KING7EVEN-LABS/PCB-DESIGN/ALTIUM DESIGN/README.md

# 🛠️ Altium Designer Hardware Projects

Welcome to the central hardware repository for custom Altium Designer PCB projects. This workspace contains fully engineered, multi-layer PCB layouts, custom library components, and manufacturing output files.

---

## 📁 Repository Directory & Projects

| Project Directory | Architecture / MCU | Layers | Description | Status |
| :--- | :--- | :---: | :--- | :---: |
| 🚀 [**ESP32-S3-DevKitM-1 Custom 4-Layer Hardware Baseboard**](./ESP32-S3-DevKitM-1%20Custom%204-Layer%20Hardware%20Baseboard/) | ESP32-S3 (Wi-Fi / BLE) | 4-Layer | High-speed IoT baseboard with native USB-C, custom footprints, and RF clearance | Completed |
| ⚡ [**ATMega 2560 Pro Square Form-Factor Controller Board**](./ATMega%202560%20Pro%20Square%20Form-Factor%20Controller%20Board/) | ATmega2560-16AU (AVR) | 4-Layer | Compact square form-factor MCU layout with optimized pin breakout & PDN | Completed |

---

## ⚙️ Standard Project Architecture

Every sub-directory in this repository adheres to a strict manufacturing-ready structure:

* `Docs/` — Component datasheets & pinout reference sheets.
* `Images/` — High-resolution renders, layer breakdowns, and schematics.
* `Libs/` — Custom integrated library packages, schematic libraries, footprint libraries and Component 3D STEP models. ( `LibPkg`, `.SchLib`, `.PcbLib`, `STEP`).
* `PDFs/` — Schematic & PCB Layout PDF exports.
* `Project Outputs/` — Gerber files (RS-274X), NC Drill, BOM, and Pick & Place (CPL) files.

---

## 👤 Author & Maintainer

<p align="center">
  <b>Designed & Engineered by Kousik P</b><br>
  <i>Hardware / PCB Design Engineer</i>
</p>

<p align="center">
  
  
  
</p>
