KING7EVEN-LABS/PCB-DESIGN/ALTIUM DESIGN/ESP32-S3-DevKitM-1 Custom 4-Layer Hardware Baseboard/Docs/ESP32 pinout sheet.xlsx

1 | GND_01
2 | GND_02
3 | 3V3
4 | GPIO0/RTC_GPIO0
5 | GPIO1/RTC_GPIO1/TOUCH1/ADC1_CH0
6 | GPIO2/RTC_GPIO2/TOUCH2/ADC1_CH1
7 | GPIO3/RTC_GPIO3/TOUCH3/ADC1_CH2
8 | GPIO4/RTC_GPIO4/TOUCH4/ADC1_CH3
9 | GPIO5/RTC_GPIO5/TOUCH5/ADC1_CH4
10 | GPIO6/RTC_GPIO6/TOUCH6/ADC1_CH5
11 | GPIO7/RTC_GPIO7/TOUCH7/ADC1_CH6
12 | GPIO8/RTC_GPIO8/TOUCH8/ADC1_CH7/SUBSPICS1
13 | GPIO9/RTC_GPIO9/TOUCH9/ADC1_CH8/FSPIHD/SUBSPIHD
14 | GPIO10/RTC_GPIO10/TOUCH10/ADC1_CH9/FSPICS0/FSPIIO4/SUBSPICS0
15 | GPIO11/RTC_GPIO11/TOUCH11/ADC2_CH0/FSPID/FSPIIO5/SUBSPID
16 | GPIO12/RTC_GPIO12/TOUCH12/ADC2_CH1/FSPICLK/FSPIIO6/SUBSPICLK
17 | GPIO13/RTC_GPIO13/TOUCH13/ADC2_CH2/FSPIQ/FSPIIO7/SUBSPIQ
18 | GPIO14/RTC_GPIO14/TOUCH14/ADC2_CH3/FSPIWP/FSPIDQS/SUBSPIWP
19 | GPIO15/RTC_GPIO15/U0RTS/ADC2_CH4/XTAL_32K_P
20 | GPIO16/RTC_GPIO16/U0CTS/ADC2_CH5/XTAL_32K_N
21 | GPIO17/RTC_GPIO17/U1TXD/ADC2_CH6
22 | GPIO18/RTC_GPIO18/U1RXD/ADC2_CH7/CLK_OUT3
23 | USB_D-/RTC_GPIO19/GPIO19/U1RTS/ADC2_CH8/CLK_OUT2
24 | USB_D+/RTC_GPIO20/GPIO20/U1CTS/ADC2_CH9/CLK_OUT1
25 | GPIO21/RTC_GPIO21
26 | GPIO26/SPICS1
27 | GPIO47/SPICLK_P_DIFF/SUBSPICLK_P_DIFF
28 | GPIO33/SPIIO4/FSPIHD/SUBSPIHD
29 | GPIO34/SPIIO5/FSPICS0/SUBSPICS0
30 | GPIO48/SPICLK_N_DIFF/SUBSPICLK_N_DIFF
31 | GPIO35/SPIIO6/FSPID/SUBSPID
32 | GPIO36/SPIIO7/FSPICLK/SUBSPICLK
33 | GPIO37/SPIDQS/FSPIQ/SUBSPIQ
34 | GPIO38/FSPIWP/SUBSPIWP
35 | MTCK/GPIO39/CLK_OUT3/SUBSPICS1
36 | MTDO/GPIO40/CLK_OUT2
37 | MTDI/GPIO41/CLK_OUT1
38 | MTMS/GPIO42
39 | U0TXD/GPIO43/CLK_OUT1
40 | U0RXD/GPIO44/CLK_OUT2
41 | GPIO45
42 | GND
43 | GND
44 | GPIO46
45 | EN
46 | GND_46
47 | GND_47
48 | GND_48
49 | GND_49
50 | GND_50
51 | GND_51
52 | GND_52
53 | GND_53
54 | GND_54
55 | GND_55
56 | GND_56
57 | GND_57
58 | GND_58
59 | GND_59
60 | GND_60
61 | GND_61
62 | GND_62
63 | GND_63
64 | GND_64
65 | GND_65
66 | GND_66
67 | GND_67
68 | GND_68
69 | GND_69
70 | GND_70
71 | GND_71
72 | GND_72
73 | GND_73
