KING7EVEN-LABS/PCB-DESIGN/ALTIUM DESIGN/ATMega 2560 Pro Square Form-Factor Controller Board/Docs/ATmega_2560_schematic.png

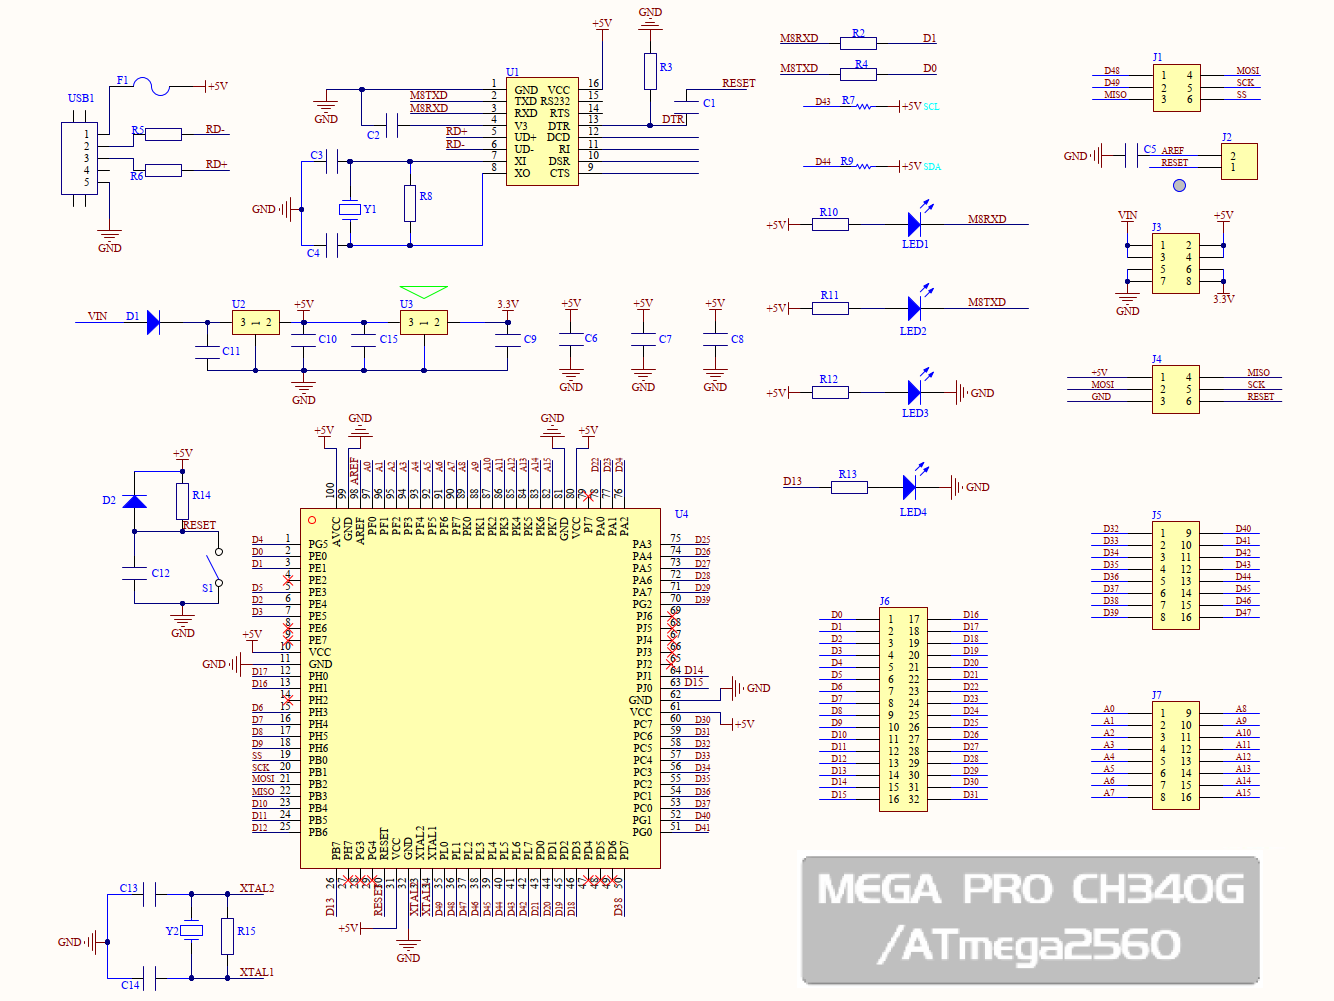
ALTIUM DESIGN/ATMega 2560 Pro Square Form-Factor Controller Board/Docs/ATmega_2560_schematic.png
