KING7EVEN-LABS/PCB-DESIGN/ALTIUM DESIGN/ATMega 2560 Pro Square Form-Factor Controller Board/Images/ATmega 2560 Footprint.png

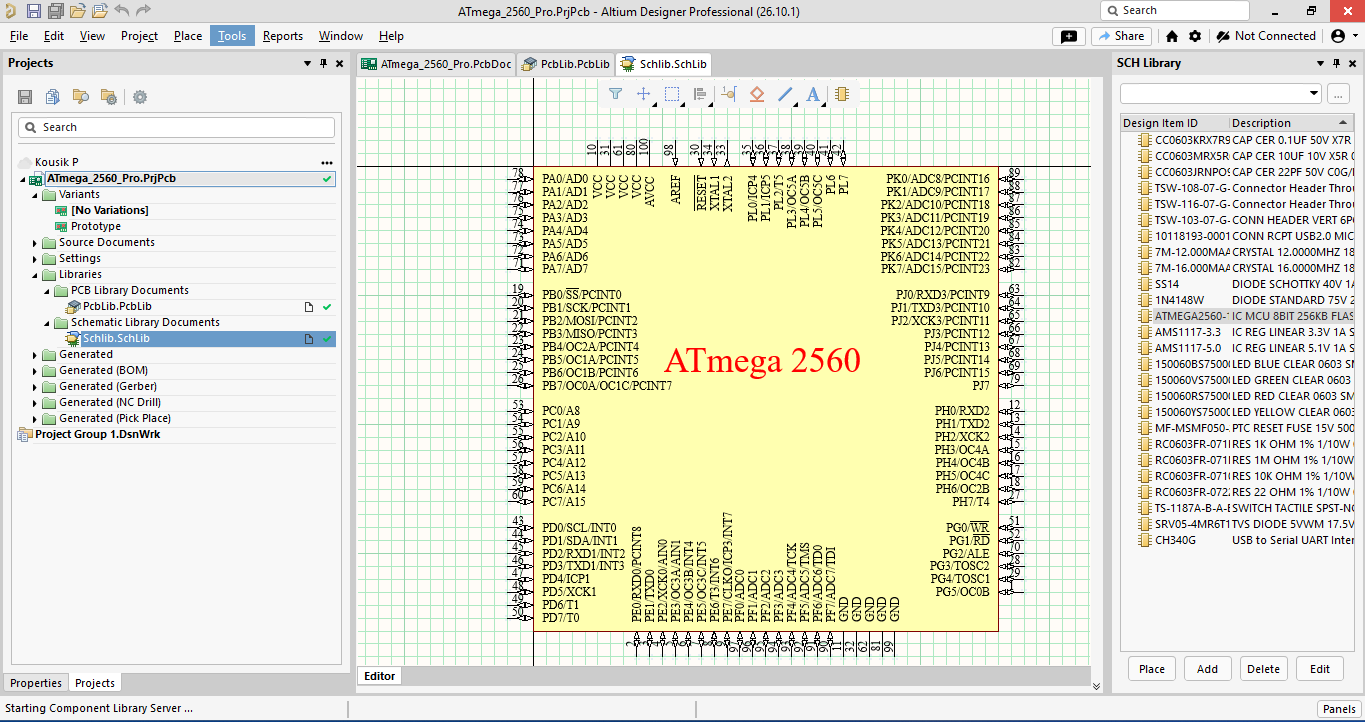
ALTIUM DESIGN/ATMega 2560 Pro Square Form-Factor Controller Board/Images/ATmega 2560 Footprint.png
