KING7EVEN-LABS/PCB-DESIGN/ALTIUM DESIGN/ESP32-S3-DevKitM-1 Custom 4-Layer Hardware Baseboard/Images/ESP32 S3 Footprint.png

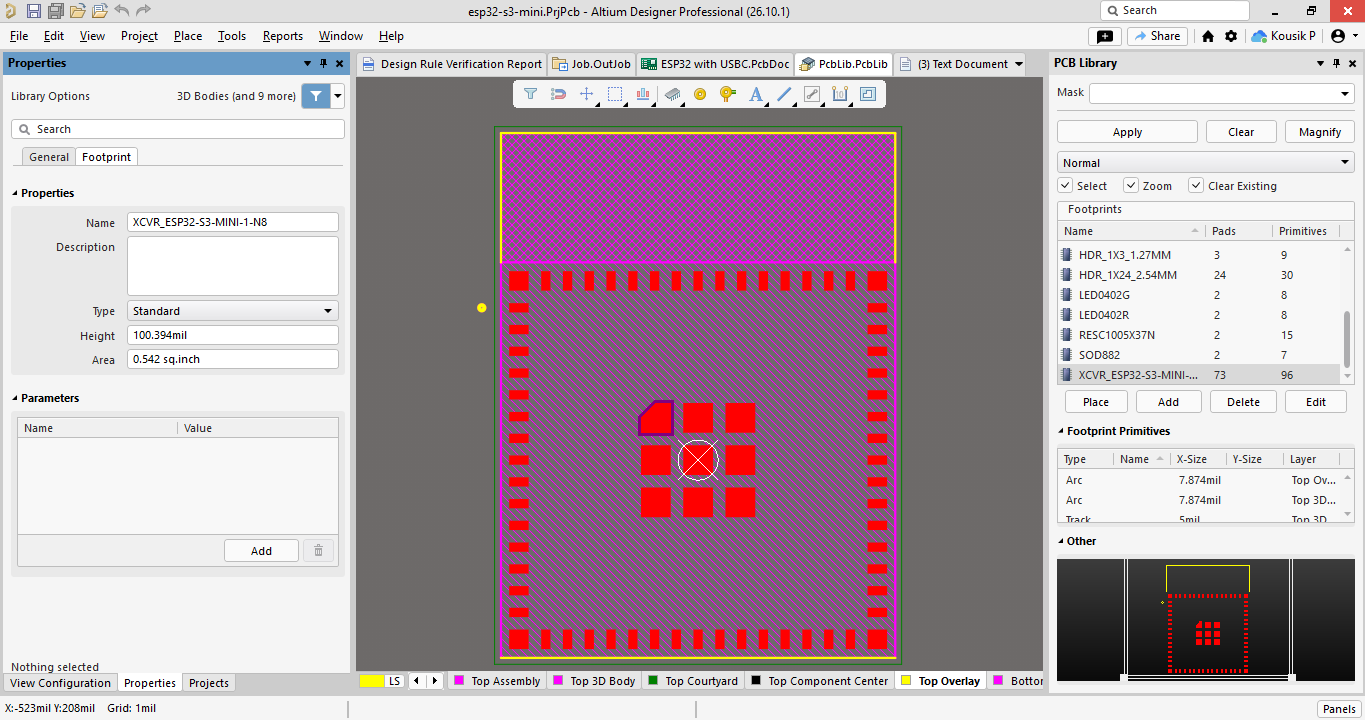
ALTIUM DESIGN/ESP32-S3-DevKitM-1 Custom 4-Layer Hardware Baseboard/Images/ESP32 S3 Footprint.png
