KING7EVEN-LABS/PCB-DESIGN/ALTIUM DESIGN/ATMega 2560 Pro Square Form-Factor Controller Board/Project Outputs for ATmega_2560_Pro/BOM/Bill of Materials-ATmega_2560_Pro(Prototype).xlsx

Name | Description | Designator | Footprint | LibRef | Quantity | Manufacturer | Supplier | Supplier Part Number
100nF | CAP CER 0.1UF 50V X7R 0603 | C1, C2, C7, C9, C10, C11, C12, C13, C14 | CAPC1608X90 - 100NF | CC0603KRX7R9BB104 | 9
22pF | CAP CER 22PF 50V C0G/NPO 0603 | C3, C4, C15, C16 | CAPC1608X90 - 22PF | CC0603JRNPO9BN220 | 4
10uF | CAP CER 10UF 10V X5R 0603 | C5, C6, C8 | CAPC1608X90 - 10UF | CC0603MRX5R6BB106 | 3 | Yageo Group | DigiKey | 311-1817-1-ND
1N4148W | DIODE STANDARD 75V 250MA SOD123 | D1 | SOD123_DIO | 1N4148W | 1
SS14 | DIODE SCHOTTKY 40V 1A DO214AC | D2 | DIOM4325X250N | SS14 | 1 | Taiwan Semiconductor | DigiKey | 1801-SS14CT-ND
500mA PTC | PTC RESET FUSE 15V 500MA 1812 | F1 | FUSM4632X85 | MF-MSMF050-2 | 1 | Bourns | DigiKey | MF-MSMF050-2CT-ND
Header Through Hole 32 position | Connector Header Through Hole 32 position 0.100" (2.54mm) | H1, H2 | SAMTEC_TSW-116-07-G-D | TSW-116-07-G-D | 2 | Samtec | DigiKey | 612-TSW-116-07-G-D-ND
Header Through Hole 16 position | Connector Header Through Hole 16 position 0.100" (2.54mm) | H3 | SAMTEC_TSW-108-07-G-D | TSW-108-07-G-D | 1 | Samtec | DigiKey | 612-TSW-108-07-G-D-ND
Header Through Hole 6 position | CONN HEADER VERT 6POS 2.54MM | H4 | SAMTEC_TSW-103-07-G-D | TSW-103-07-G-D | 1 | Samtec | DigiKey | 612-TSW-103-07-G-D-ND
Green Led | LED GREEN CLEAR 0603 SMD | LED1 | WL-SMCW_0603-G | 150060VS75000 | 1 | Wurth Elektronik | DigiKey | 732-4980-1-ND
Yellow Led | LED YELLOW CLEAR 0603 SMD | LED2 | WL-SMCW_0603-Y | 150060YS75000 | 1 | Wurth Elektronik | DigiKey | 732-4981-1-ND
Red Led | LED RED CLEAR 0603 SMD | LED3 | WL-SMCW_0603-R | 150060RS75000 | 1 | Wurth Elektronik | DigiKey | 732-4978-6-ND
Blue Led | LED BLUE CLEAR 0603 SMD | LED4 | WL-SMCW_0603-B | 150060BS75000 | 1 | Wurth Elektronik | DigiKey | 732-4966-6-ND
10k | RES 10K OHM 1% 1/10W 0603 | R1, R9, R10, R11 | RESC1607X60N - 10K | RC0603FR-0710KL | 4
22 | RES 22 OHM 1% 1/10W 0603 | R2, R3 | RESC1607X60N - 22 | RC0603FR-0722RL | 2 | Yageo Group | DigiKey | 311-22.0HRCT-ND
1M | RES 1M OHM 1% 1/10W 0603 | R4, R12 | RESC1607X60N - 1M | RC0603FR-071ML | 2
1k | RES 1K OHM 1% 1/10W 0603 | R5, R6, R7, R8, R13, R14 | RESC1607X60N - 1K | RC0603FR-071KL | 6
SW | SWITCH TACTILE SPST-NO 0.05A 12V SMD 3X4MM | S1 | SW_TS-1187A-B-A-B | TS-1187A-B-A-B | 1
CH340G | USB to Serial UART Interface Controller IC, SOP-16, 5V/3.3V, 12MHz External Crystal Required | U1 | SOP127P780X200-16N | CH340G | 1
AMS1117-5.0 | IC REG LINEAR 5.1V 1A SOT-223-3L | U2 | SOT229P700X180-4N-5.0 | AMS1117-5.0 | 1 | Revvo | DigiKey | 5272-AMS1117-5.0TR-ND
AMS1117-3.3 | IC REG LINEAR 3.3V 1A SOT-223-3L | U3 | SOT229P700X180-4N-3.3 | AMS1117-3.3 | 1 | UMW(Youtai Semiconductor Co., Ltd.) | DigiKey | 4518-AMS1117-3.3TR-ND
SRV05-4 | TVS DIODE 5VWM 17.5VC 6TSOP | U4 | TSOP6_3P1X1P7_ONS | SRV05-4MR6T1G | 1 | onsemi | DigiKey | 488-SRV05-4MR6T1GDKR-ND
ATMEGA2560-16AU | IC MCU 8BIT 256KB FLASH 100TQFP | U5 | QFP50P1600X1600X120-100N | ATMEGA2560-16AU | 1 | Microchip | DigiKey | ATMEGA2560-16AU-ND
Micro-USB-B | CONN RCPT USB2.0 MICRO B SMD R/A | USB1 | AMPHENOL_10118193-0001LF | 10118193-0001LF | 1 | Amphenol Communications Solutions | DigiKey | 609-4616-1-ND
12MHz | CRYSTAL 12.0000MHZ 18PF SMD | X1 | OSCCC250X320X70-4N | 7M-12.000MAAJ-T | 1
16MHZ | CRYSTAL 16.0000MHZ 18PF SMD | X2 | XTAL_7M-16.000MAAJ-T | 7M-16.000MAAJ-T | 1
