KING7EVEN-LABS/PCB-DESIGN/ALTIUM DESIGN/ESP32-S3-DevKitM-1 Custom 4-Layer Hardware Baseboard/Project Outputs for esp32-s3-mini/BOM/Bill of Materials-esp32-s3-mini(Prototype).xlsx

Name | Description | Designator | Footprint | LibRef | Quantity | LCSC Part Number | Manufacturer | Manufacturer Part Number | Supplier | Supplier Part Number
4u7,16v | CAP CER 4.7UF 16V X5R 0402 | C1, C11 | CAPC1005X65N | CL05A475MO5NUNC | 2 | C318563 | Samsung Electro-Mechanics | CL05A475MO5NUNC | DigiKey | 1276-6836-6-ND
100nF 50V | CAP CER 0.1UF 50V X7R 0402 | C2, C3, C4, C5, C6, C8, C9, C10, C15 | CAPC1005X65N | CL05B104KB54PNC | 9 | C307331 | Samsung Electro-Mechanics | CL05B104KB54PNC | DigiKey | 1276-CL05B104KB54PNCDKR-ND
10uF 10V | CAP CER 10UF 10V X5R 0402 | C12, C13, C14 | CAPC1005X65N | CL05A106MP8NUB8 | 3 | C307415 | Samsung Electro-Mechanics | CL05A106MP8NUB8 | DigiKey | 1276-6830-6-ND
1uF 35V | CAP CER 1UF 35V X5R 0402 | C16 | CAPC1005X65N | CL05A105KL5NRNC | 1 | C307413 | Samsung Electro-Mechanics | CL05A105KL5NRNC | DigiKey | 1276-6796-6-ND
AQ3045-01ETG | TVS DIODE 5.3VWM 12VC SOD882 | D1, D2, D3, D5, D6, D7 | SOD882 | AQ3045-01ETG | 6 | C3710326 | Littelfuse | AQ3045-01ETG | DigiKey | F9321CT-ND
GREEN | LED YLW-GRN 0402 SMD | D4 | LED0402G | VLMG1500-GS08 | 1 | C511404 | Vishay | VLMG1500-GS08 | DigiKey | VLMG1500-GS08DKR-ND
RED | LED RED 0402 SMD | D8 | LED0402R | VLMS1500-GS08 | 1 | C511370 | Vishay | VLMS1500-GS08 | DigiKey | VLMS1500-GS08CT-ND
22-28-4245 | CONN HEADER VERT 24POS 2.54MM | J1, J2 | HDR_1X24_2.54MM | 22-28-4245 | 2 | C7145888 | Molex | 22-28-4245 | DigiKey | 900-0022284245-ND
217179-0001 | CONN RCP USB2.0 TYP C 24P SMD RA | J3, J4 | FP-2171790001-MFG | 217179-0001 | 2 | C3197684 | Molex | 217179-0001 | DigiKey | 900-2171790001CT-ND
FTS-103-01-F-S | CONN HEADER VERT 3POS 1.27MM | J5 | HDR_1X3_1.27MM | FTS-103-01-F-S | 1 | C3333578 | Samtec | FTS-103-01-F-S | DigiKey | 612-FTS-103-01-F-S-ND
FTS-102-01-F-S | CONN HEADER VERT 2POS 1.27MM | J6 | HDR_1X2_1.27MM | FTS-102-01-F-S | 1 | C6045317 | Samtec | FTS-102-01-F-S | DigiKey | SAM15176-ND
M50-1920005 | CONN SHUNT 1.27MM RED | LINK1, LINK2 |  | M50-1920005 | 2 | C6985646 | Harwin | M50-1920005 | DigiKey | 952-1727-ND
SS8050-G | TRANS NPN 25V 1.5A SOT-23-3 | Q1, Q2 | FP-SS8050-G-IPC_B | SS8050-G | 2 | C164886 | Comchip | SS8050-G | DigiKey | 641-1790-1-ND
0R | RES 0 OHM JUMPER 1/16W 0402 | R1, R6, R21, R22, R23, R24 | RESC1005X37N | RC0402JR-070RL | 6 | C60485 | Yageo Group | RC0402JR-070RL | DigiKey | 311-0.0JRDKR-ND
27R | RES 27 OHM 1% 1/16W 0402 | R4, R5, R19, R20 | RESC1005X37N | RC0402FR-0727RL | 4 | C138021 | Yageo Group | RC0402FR-0727RL | DigiKey | YAG3086DKR-ND
4k7 | RES 4.7K OHM 1% 1/16W 0402 | R8 | RESC1005X37N | RC0402FR-074K7L | 1 | C105871 | Yageo Group | RC0402FR-074K7L | DigiKey | 311-4.7KLRCT-ND
5k1 | RES SMD 5.1K OHM 1% 1/16W 0402 | R9, R10, R13, R14 | RESC1005X37N | AC0402FR-075K1L | 4 | C144745 | Yageo Group | AC0402FR-075K1L | DigiKey | YAG3503CT-ND
10k | RES SMD 10K OHM 1% 1/16W 0402 | R11, R16, R17, R18 | RESC1005X37N | AC0402FR-0710KL | 4 | C144807 | Yageo Group | AC0402FR-0710KL | DigiKey | YAG3436DKR-ND
1k | RES 1K OHM 1% 1/16W 0402 | R12, R15 | RESC1005X37N | RC0402FR-071KL | 2 | C106235 | Yageo Group | RC0402FR-071KL | DigiKey | 311-1.00KLRDKR-ND
PTS645SH50SMTR92LFS | SWITCH TACTILE SPST-NO 0.05A 12V | SW1, SW2 | FP-PTS645SH50SMTR92LFS-MFG | PTS645SH50SMTR92LFS | 2 | C221869 | C&K Components | PTS645SH50SMTR92LFS | DigiKey | CKN9085CT-ND
ESP32-S3-MINI-1-N8 | 20.5dBm ESP32-S3FN8 Chip 2.4GHz SMD WiFi Modules ROHS | U1 | XCVR_ESP32-S3-MINI-1-N8 | ESP32-S3-MINI-1-N8 | 1 | C2913206 | Espressif Systems | ESP32-S3-MINI-1-N8 | DigiKey | 5407-ESP32-S3-MINI-1-N8DKR-ND
FT231XQ-R | IC USB SERIAL FULL UART 20QFN | U2 | FP-QFN-20-IPC_B | FT231XQ-R | 1 | C132159 | FTDI | FT231XQ-R | DigiKey | 768-1128-6-ND
TL1963A-33DCYR | IC REG LIN 3.3V 1.5A SOT-223-4 | U3 | DCY0004A_N | TL1963A-33DCYR | 1 | C181262 | Texas Instruments | TL1963A-33DCYR | DigiKey | 296-24897-1-ND
