KING7EVEN-LABS/PCB-DESIGN/ALTIUM DESIGN/ESP32-S3-DevKitM-1 Custom 4-Layer Hardware Baseboard/PDFs/Schematic.pdf

# ESP32 WITH USB-C

# USB C CONNECTOR 1

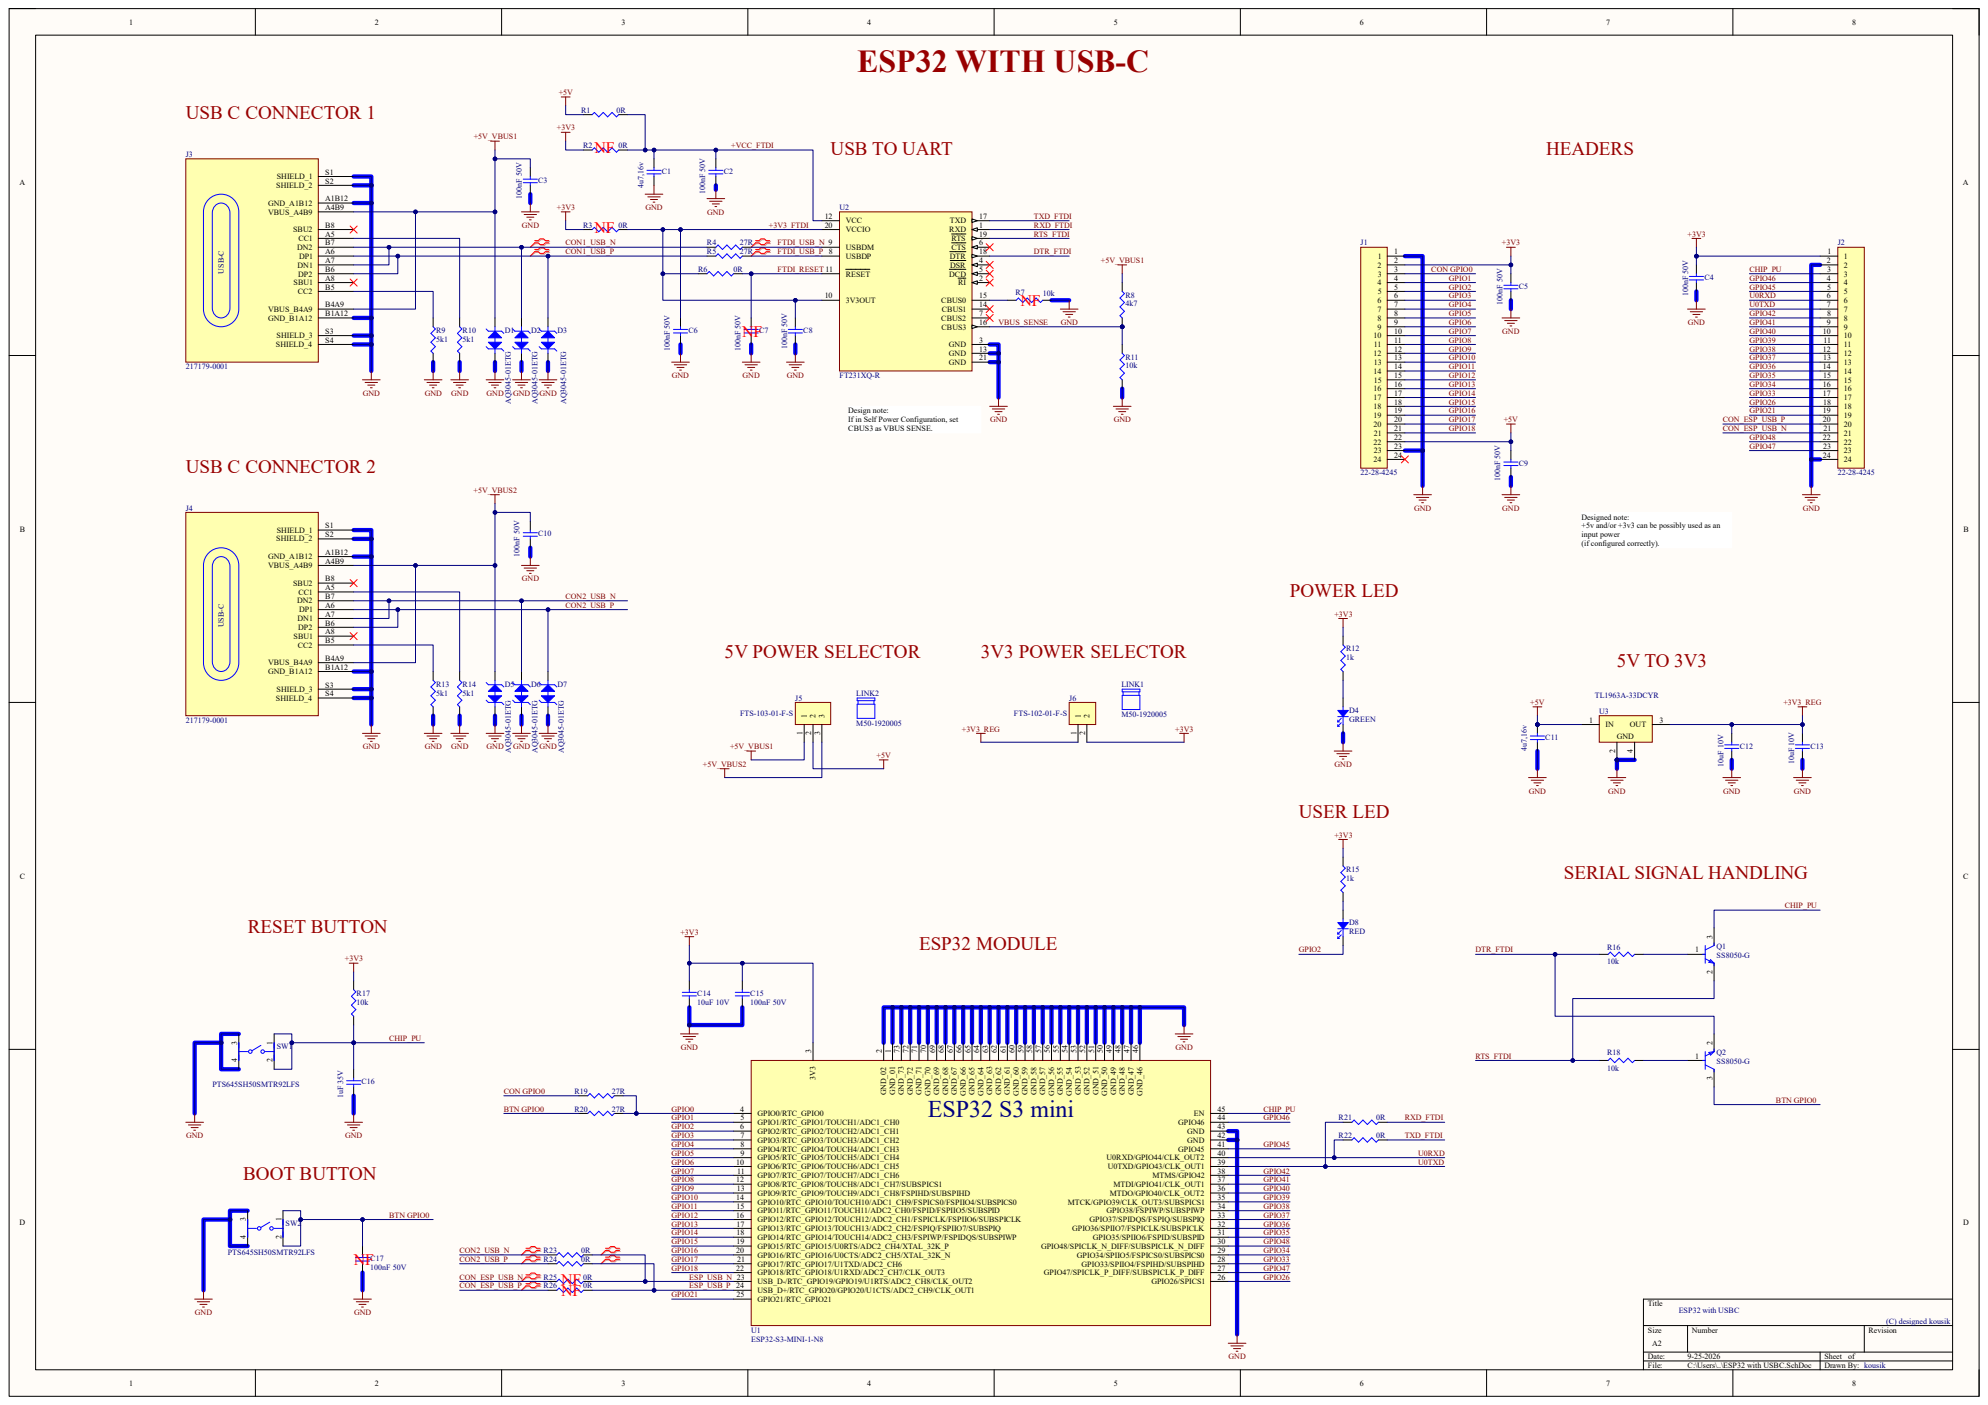
[picture p24: page 1]

D3AQ³⁰⁴⁵⁻⁰¹ETG GND GND GND

Design note:
If in Self Power Configuration, set
CBUS3 as VBUS SENSE.

Designed note:
+5v and/or +3v3 can be possibly used as an
input power
(if configured correctly).
