KING7EVEN-LABS/PCB-DESIGN/ALTIUM DESIGN/ESP32-S3-DevKitM-1 Custom 4-Layer Hardware Baseboard/PDFs/Pcb_Layout.pdf

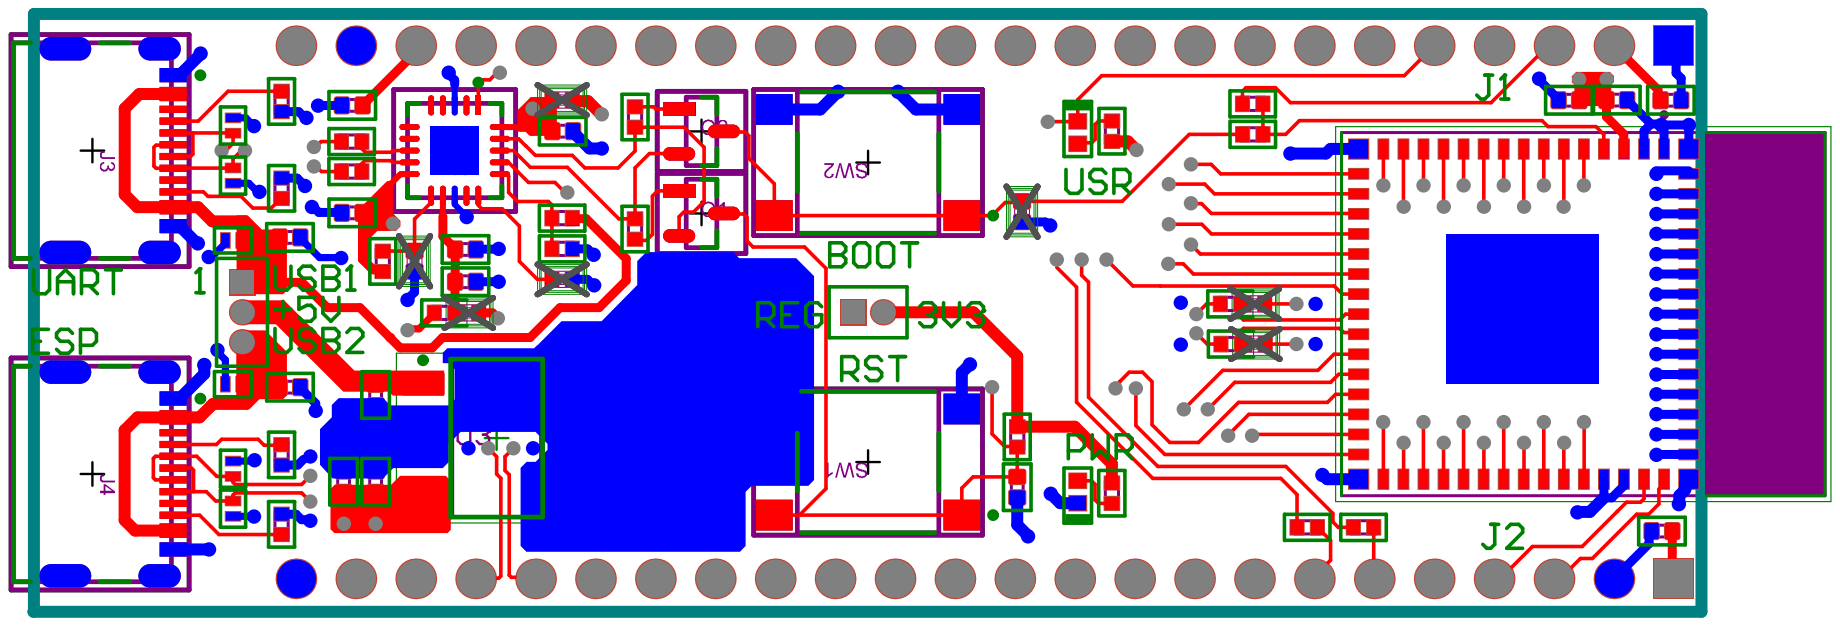
[picture p25: page 1]

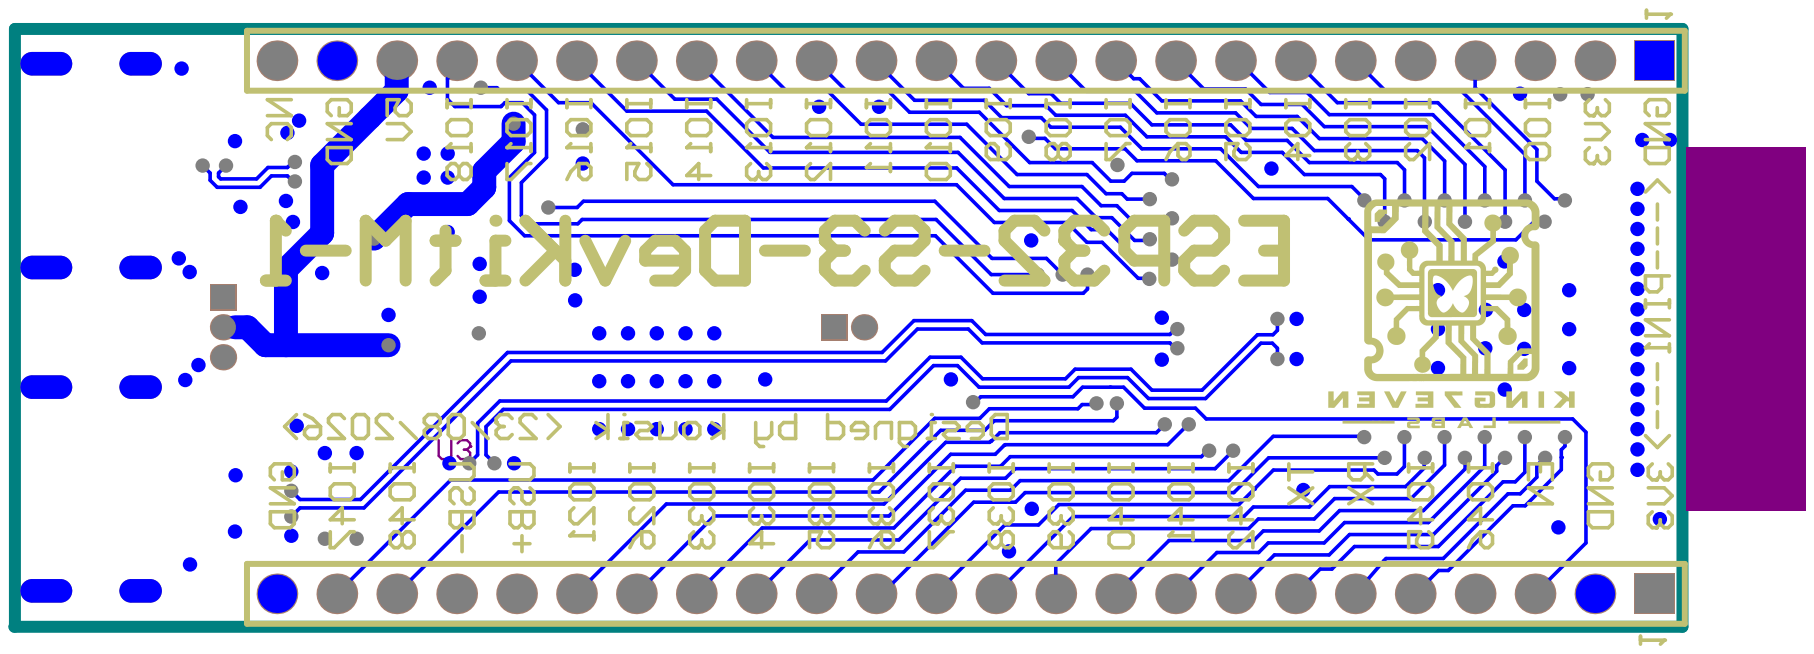
[picture p26: page 2]

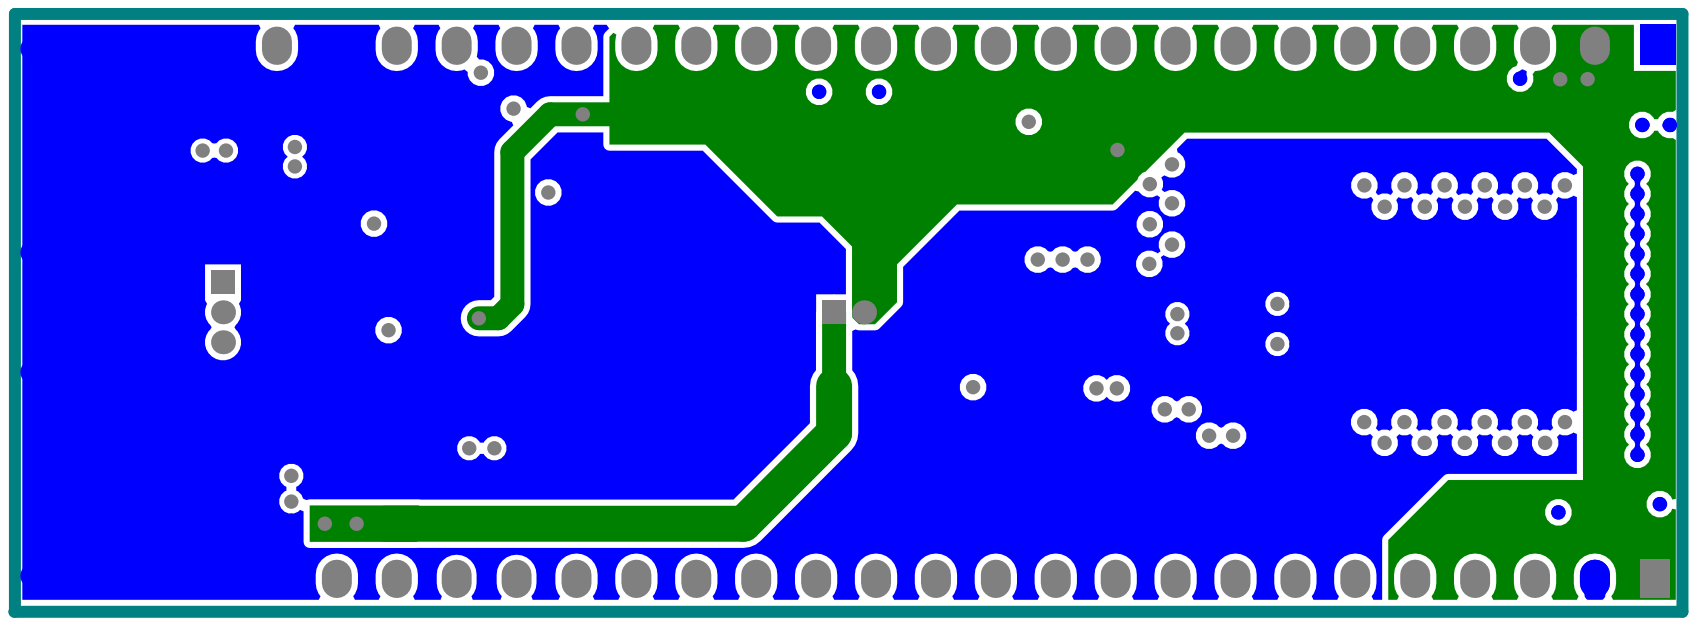
[picture p27: page 3]

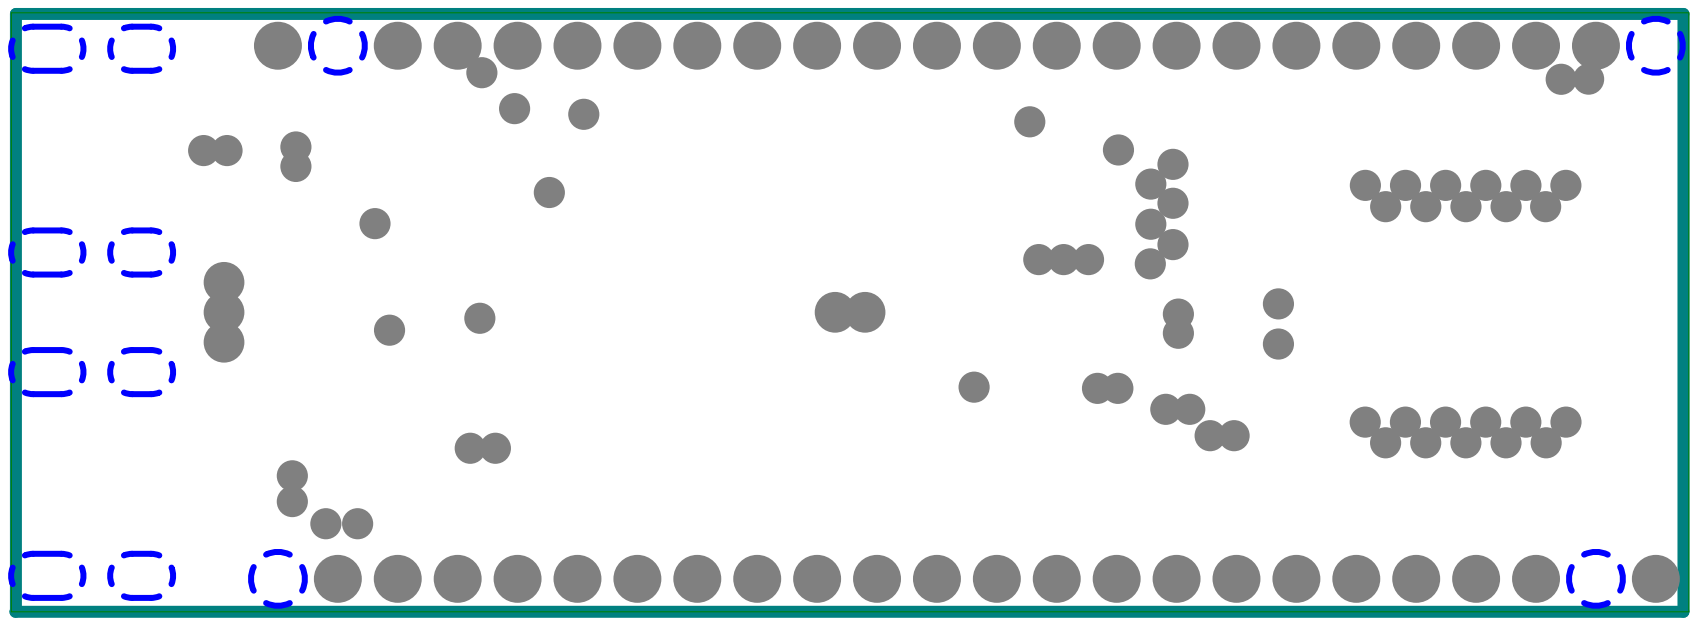
[picture p28: page 4]
