KING7EVEN-LABS/PCB-DESIGN/ALTIUM DESIGN/ATMega 2560 Pro Square Form-Factor Controller Board/Project Outputs for ATmega_2560_Pro/Job.PDF

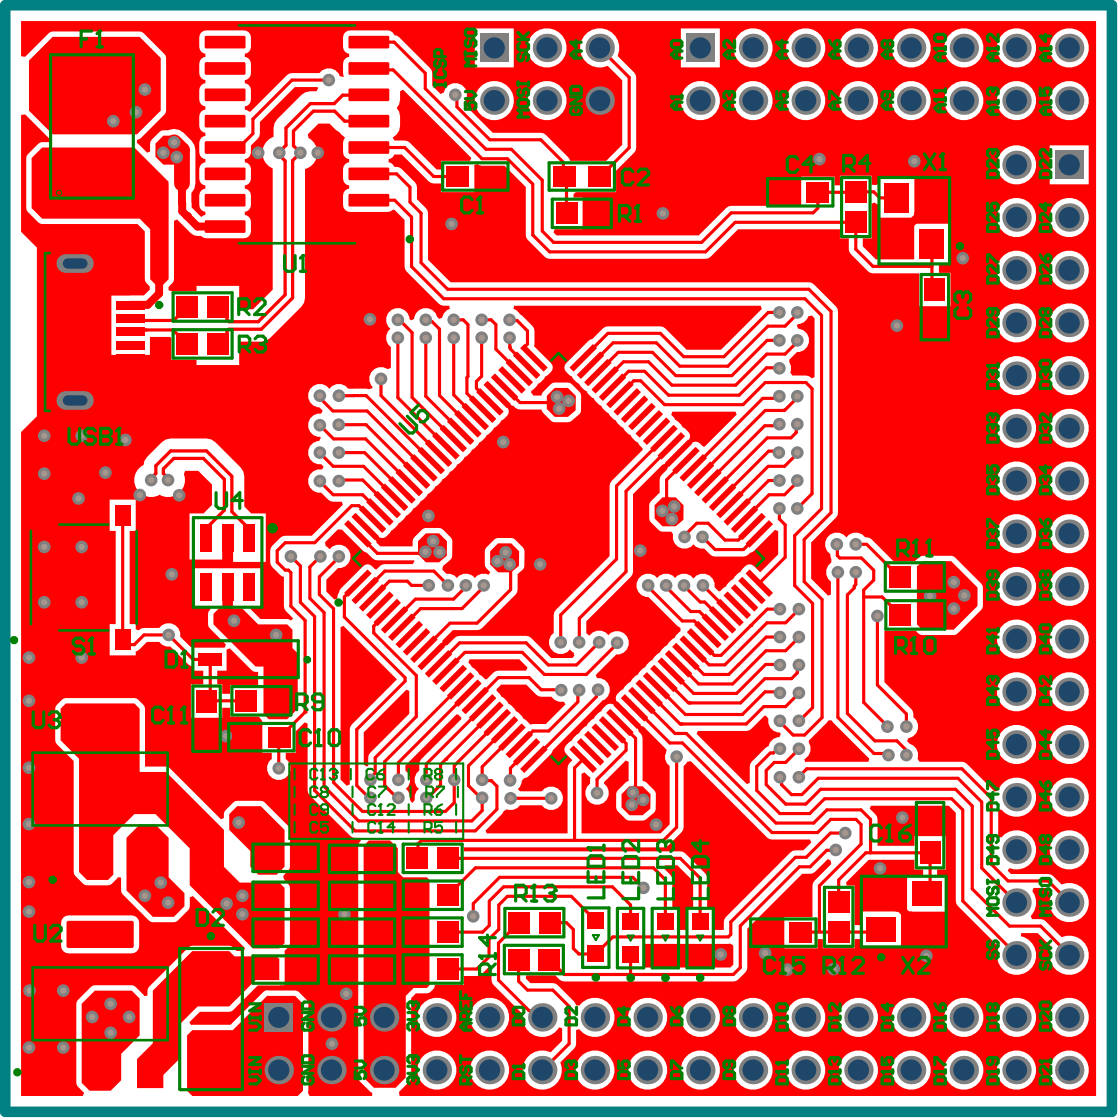
[picture p29: page 1]

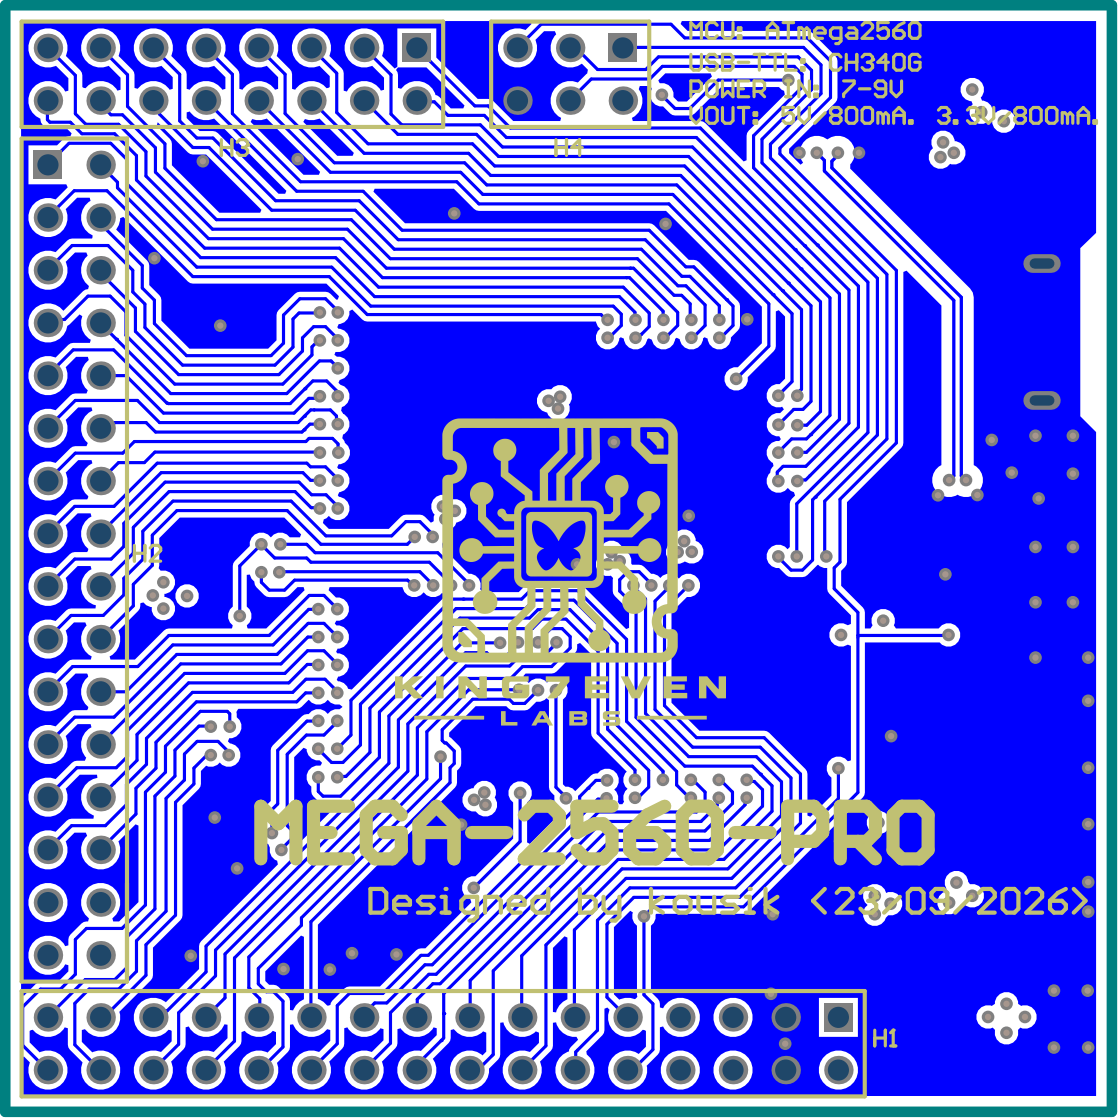
[picture p30: page 2]
