KING7EVEN-LABS/PCB-DESIGN/ALTIUM DESIGN/ESP32-S3-DevKitM-1 Custom 4-Layer Hardware Baseboard/Project Outputs for esp32-s3-mini/Job.PDF

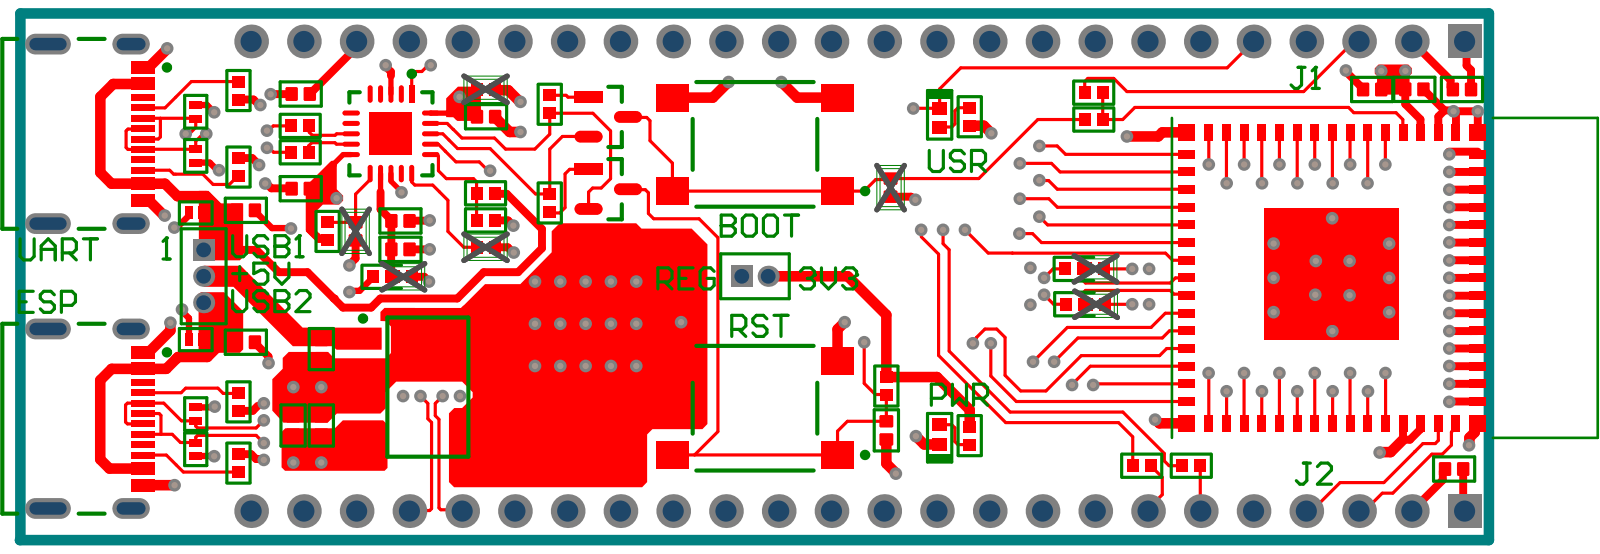
[picture p31: page 1]

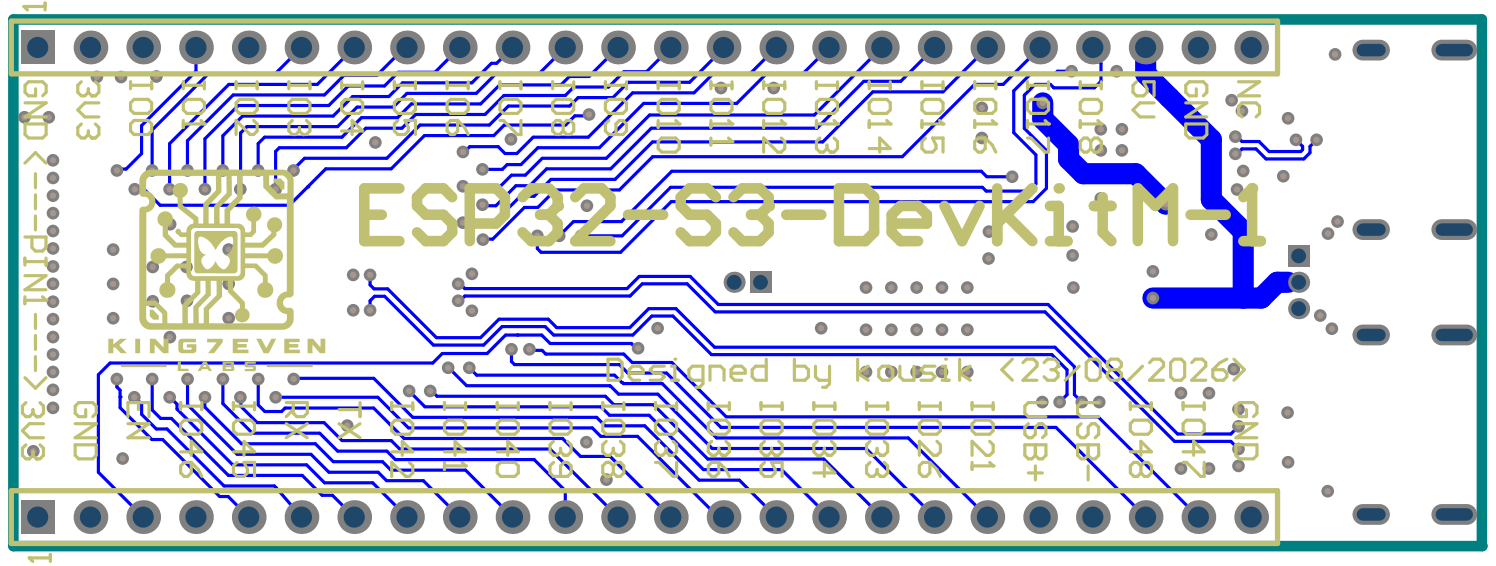
[picture p32: page 2]
