KING7EVEN-LABS/PCB-DESIGN/ALTIUM DESIGN/ATMega 2560 Pro Square Form-Factor Controller Board/PDFs/Schematic.pdf

# USB INPUT & PTC PROTECTION

CH340G USB TO SERIAL CONVERTER | DIGITAL , ANALOG , POWER & SPI HEADER

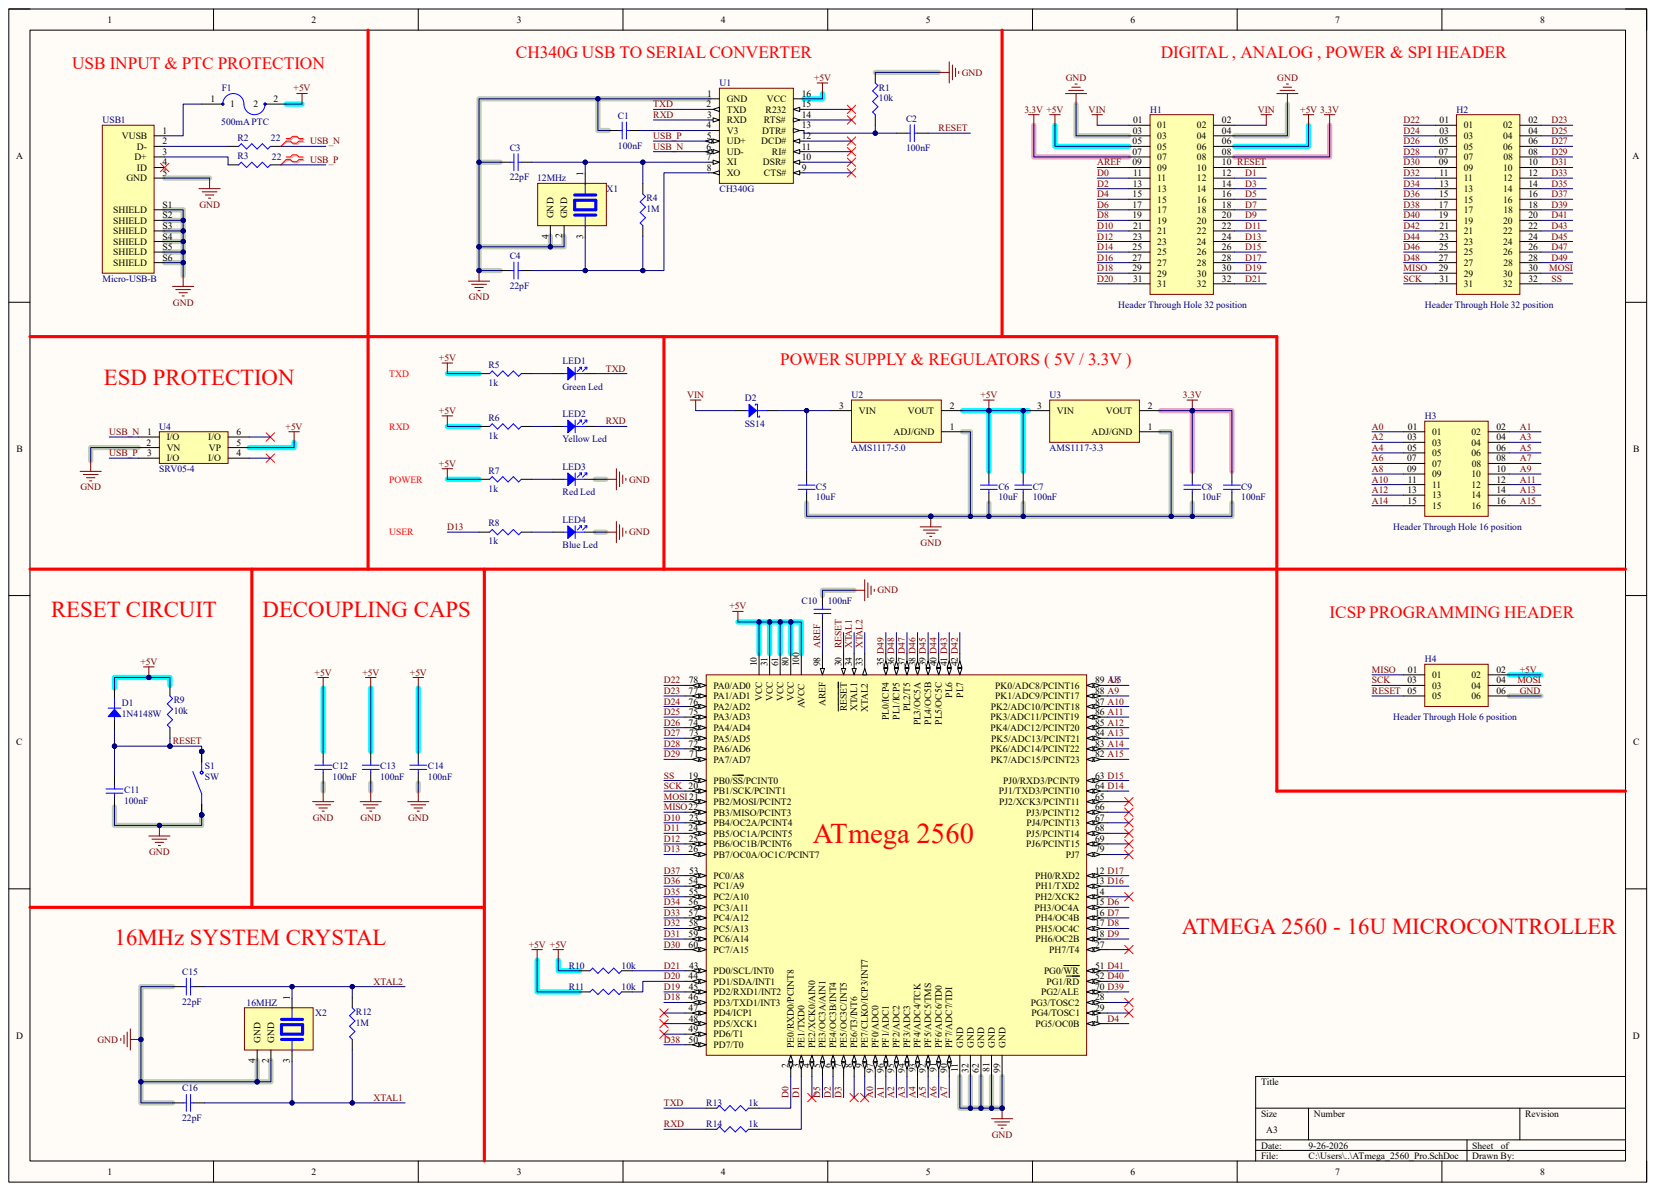
[picture p33: page 1]

Header Through Hole 32 position

Header Through Hole 16 position

ATmega 2560 RESET ³⁰ XTAL¹ ³⁴

Header Through Hole 6 position
