KING7EVEN-LABS/PCB-DESIGN/(list of files, drawings)

Other design files:
ALTIUM DESIGN/ATMega 2560 Pro Square Form-Factor Controller Board/ATmega_2560_Pro.PcbDoc
ALTIUM DESIGN/ATMega 2560 Pro Square Form-Factor Controller Board/ATmega_2560_Pro.PrjPcb
ALTIUM DESIGN/ATMega 2560 Pro Square Form-Factor Controller Board/ATmega_2560_Pro.SchDoc
ALTIUM DESIGN/ATMega 2560 Pro Square Form-Factor Controller Board/PcbLib.PcbLib
ALTIUM DESIGN/ATMega 2560 Pro Square Form-Factor Controller Board/SchLib.SchLib
ALTIUM DESIGN/ESP32-S3-DevKitM-1 Custom 4-Layer Hardware Baseboard/ESP32 with USBC.PcbDoc
ALTIUM DESIGN/ESP32-S3-DevKitM-1 Custom 4-Layer Hardware Baseboard/ESP32 with USBC.SchDoc
ALTIUM DESIGN/ESP32-S3-DevKitM-1 Custom 4-Layer Hardware Baseboard/esp32-s3-mini.PrjPcb
ALTIUM DESIGN/ESP32-S3-DevKitM-1 Custom 4-Layer Hardware Baseboard/PcbLib.PcbLib
ALTIUM DESIGN/ESP32-S3-DevKitM-1 Custom 4-Layer Hardware Baseboard/Schlib.SchLib
